Suvam1s/Human-Arm-Robot-Interfacing/README.md

# Human-Arm-Robot-Interfacing
Human arm–robot interface using MPU6050, flex sensors, and strain gauges to capture motion and finger activity. Processes signals to control a robotic hand in real time, with support for both wired and wireless communication for flexible operation.
