Suvam1s/Human-Arm-Robot-Interfacing/Introduction.md

# Human Motion Controlled Robotic Arm
### A Biomedical Instrumentation and Embedded Systems Project

## Overview

This repository presents the complete design, development, and implementation of a **Human Motion Controlled Robotic Arm** developed as an interdisciplinary engineering project integrating **Biomedical Engineering, Embedded Systems, Analog Electronics, Signal Processing, Mechanical Design, and Control Systems**.

The objective of this project extends beyond simply building a robotic arm. It serves as a comprehensive demonstration of designing a complete sensing and actuation system—from raw biological motion acquisition to stable real-time robotic control. Every stage of the system, including sensing, analog front-end design, signal conditioning, mathematical analysis, firmware development, mechanical integration, and simulation, has been developed and documented.

Unlike conventional robotic arm projects that directly interface sensors with microcontrollers, this project focuses heavily on the **engineering of reliable sensor interfaces** capable of extracting usable information from extremely small and noisy analog signals.

---

## Project Objective

Human joint motion generates sensor outputs that are often nonlinear, low amplitude, highly susceptible to electrical noise, and unsuitable for direct acquisition by a microcontroller.

The primary objective of this work is therefore to design a complete acquisition and control pipeline capable of:

- Acquiring weak analog signals from wearable sensing systems.
- Eliminating unwanted electrical noise while preserving useful motion information.
- Amplifying very low-frequency signals without introducing instability or amplifier saturation.
- Designing analog front-end circuits that remain stable over varying operating conditions.
- Producing clean, repeatable analog outputs suitable for ADC acquisition.
- Translating processed sensor signals into smooth robotic joint movements in real time.

The resulting system demonstrates a complete sensor-to-actuator pipeline rather than simply servo motor control.

---

## Engineering Scope

This repository combines multiple engineering disciplines into a single integrated project.

### Biomedical Instrumentation

- Human motion acquisition
- Wearable sensing techniques
- Joint angle estimation
- Biomechanical motion replication

### Analog Circuit Design

- Signal conditioning
- Precision amplification
- Active filtering
- Biasing circuits
- Wheatstone bridge implementation
- Sensor interface development
- Stable analog front-end design

### Signal Processing

Particular emphasis has been placed on extracting meaningful information from extremely low-frequency analog signals generated by wearable sensors.

The signal processing pipeline focuses on:

- Removal of unwanted electrical noise
- Isolation of useful low-frequency motion components
- Gain optimization
- Prevention of amplifier saturation
- Stable amplification of weak sensor outputs
- Analog signal conditioning suitable for ADC acquisition
- Reliable sensor calibration
- Real-time signal interpretation

The objective is not simply amplification, but the generation of clean, repeatable, and stable sensor outputs that can be used for accurate robotic control without jitter or instability.

### Embedded Systems

- ESP32 firmware development
- Real-time sensor acquisition
- PWM servo control
- ADC interfacing
- I²C communication
- Motion control algorithms

### Mechanical Design

The robotic arm has been mechanically designed to balance structural rigidity, low weight, and actuator efficiency through:

- Custom CAD modelling
- Servo mounting architecture
- Lightweight PVC structural members
- Spring-assisted elbow support
- Bearing-supported shoulder rotation
- Reinforced mechanical joints

---

## Sensor Technologies

The robotic arm employs multiple sensing technologies, each selected according to the biomechanics of the corresponding human joint.

- MPU6050 Inertial Measurement Unit for shoulder orientation.
- Flex Sensor for elbow motion detection.
- Four-element strain gauge system for wrist bend estimation.

Each sensing system is paired with a dedicated analog conditioning stage before being interfaced with the ESP32.

---

## Control Strategy

The robotic arm follows a **master-slave teleoperation architecture**, where human motion directly determines robotic joint movement.

Instead of autonomous trajectory planning, the system performs:

- Sensor acquisition
- Analog signal conditioning
- Motion estimation
- Joint angle mapping
- Real-time servo actuation

This approach allows natural replication of human arm movement while maintaining stable operation and predictable joint behaviour.

---

## Project Deliverables

This repository contains the complete engineering workflow behind the project, including:

- Mechanical CAD models
- Circuit design
- Signal conditioning circuitry
- Mathematical derivations
- MATLAB analysis and simulations
- Embedded firmware
- Experimental validation
- Design documentation
- Engineering calculations
- Assembly resources

---

## Purpose of this Repository

This repository is intended to serve as both a project archive and an engineering portfolio demonstrating practical experience in:

- Biomedical instrumentation
- Embedded systems
- Analog electronics
- Signal conditioning
- Sensor interface design
- Real-time control systems
- Mechanical system integration
- MATLAB modelling and simulation
- Firmware development
- Engineering documentation

Rather than focusing on a single subsystem, this project demonstrates the complete engineering workflow required to transform weak physiological motion signals into reliable robotic actuation through carefully designed sensing, analog processing, digital control, and mechanical implementation.
