Suvam1s/Human-Arm-Robot-Interfacing/Control Systems/Flex Sensor Control/Circuits/Lowpass filter.png

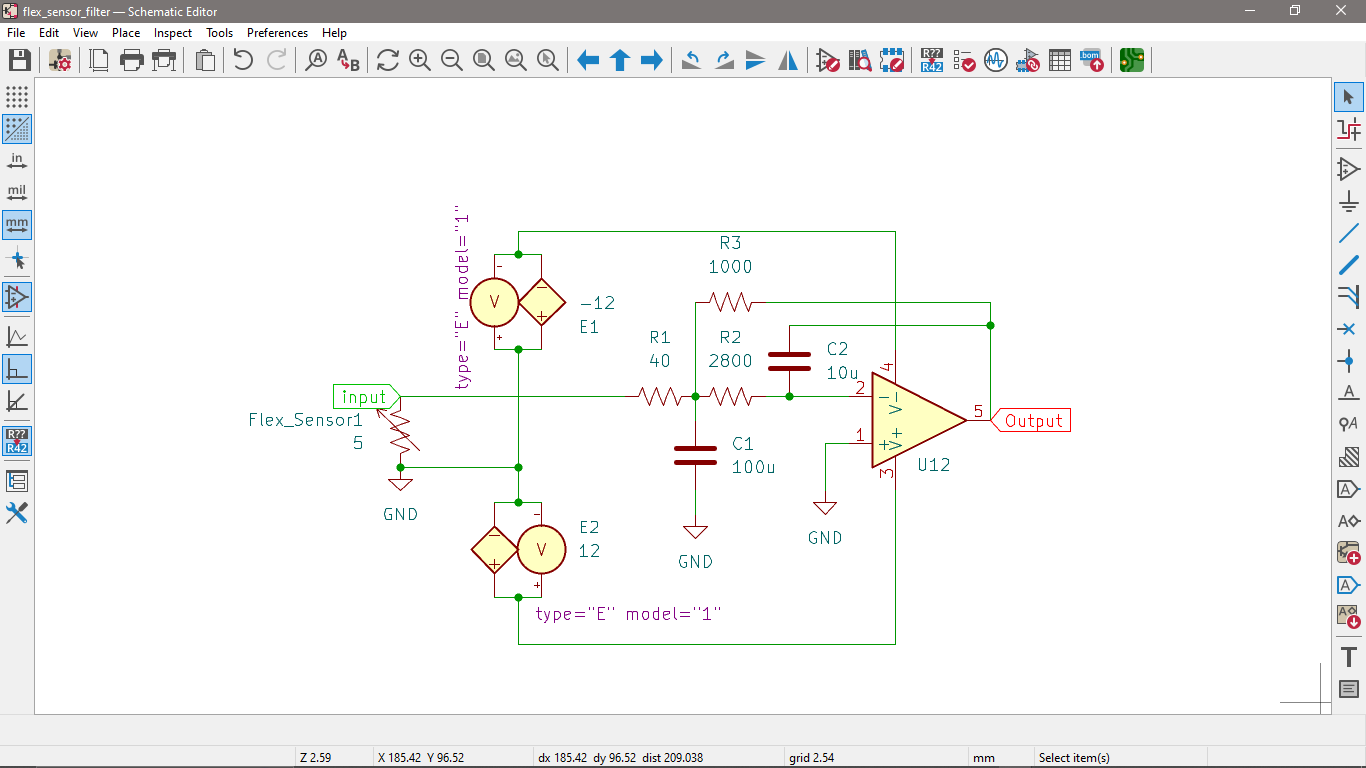
Control Systems/Flex Sensor Control/Circuits/Lowpass filter.png
