Suvam1s/Human-Arm-Robot-Interfacing/Control Systems/Flex Sensor Control/Matlab simulation/Control Data extraction/output simulation.png

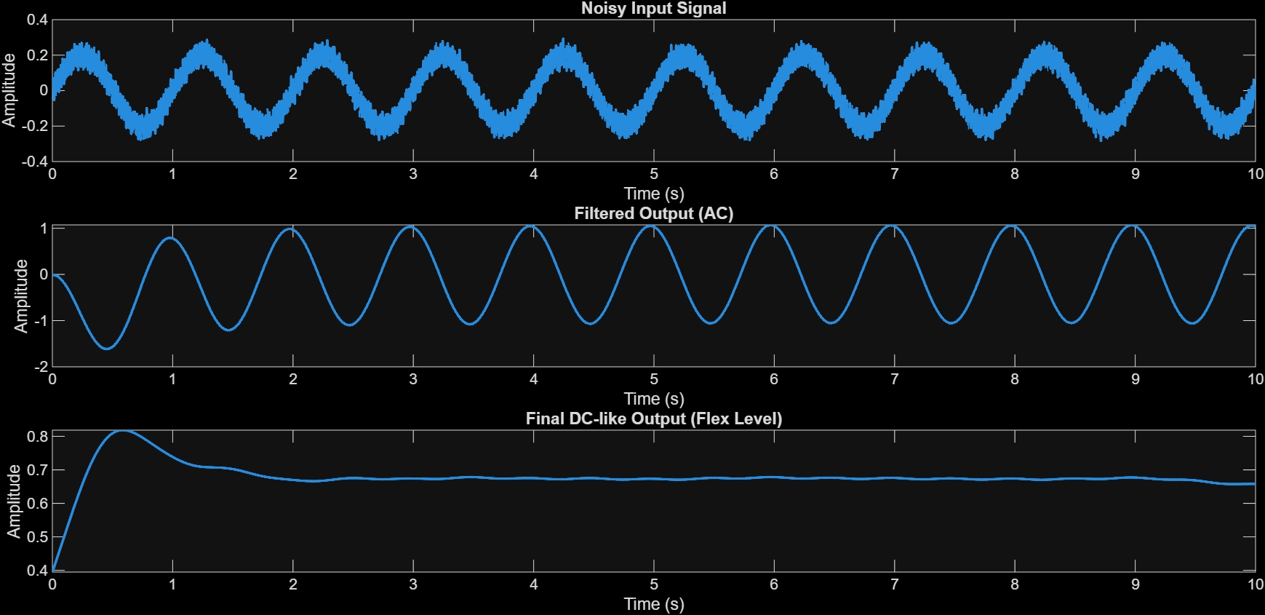
Control Systems/Flex Sensor Control/Matlab simulation/Control Data extraction/output simulation.png
