Suvam1s/Human-Arm-Robot-Interfacing/Control Systems/Flex Sensor Control/Matlab simulation/Lowpass Filter trans data/3D s plane.png

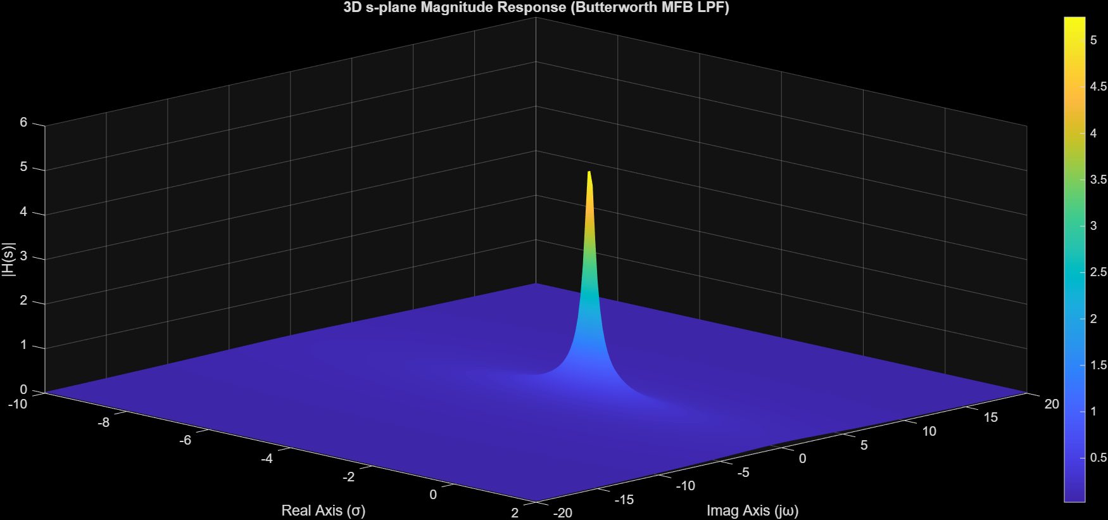
Control Systems/Flex Sensor Control/Matlab simulation/Lowpass Filter trans data/3D s plane.png
