Suvam1s/Human-Arm-Robot-Interfacing/Control Systems/Flex Sensor Control/Matlab simulation/Lowpass Filter trans data/Impulse Response.png

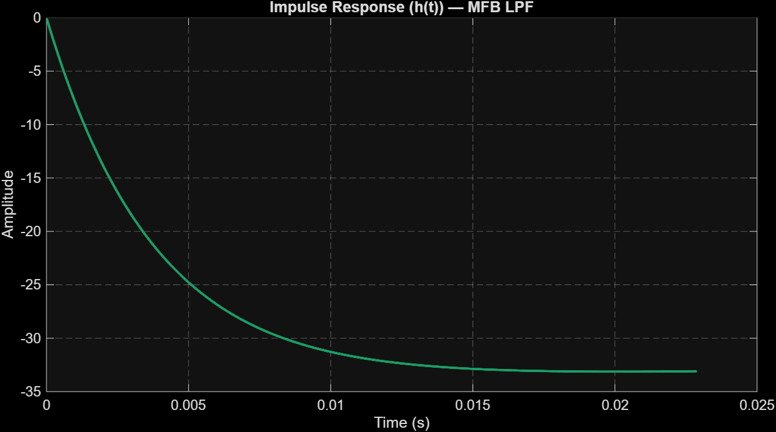
Control Systems/Flex Sensor Control/Matlab simulation/Lowpass Filter trans data/Impulse Response.png
