Suvam1s/Human-Arm-Robot-Interfacing/Control Systems/Full System Circuit.png

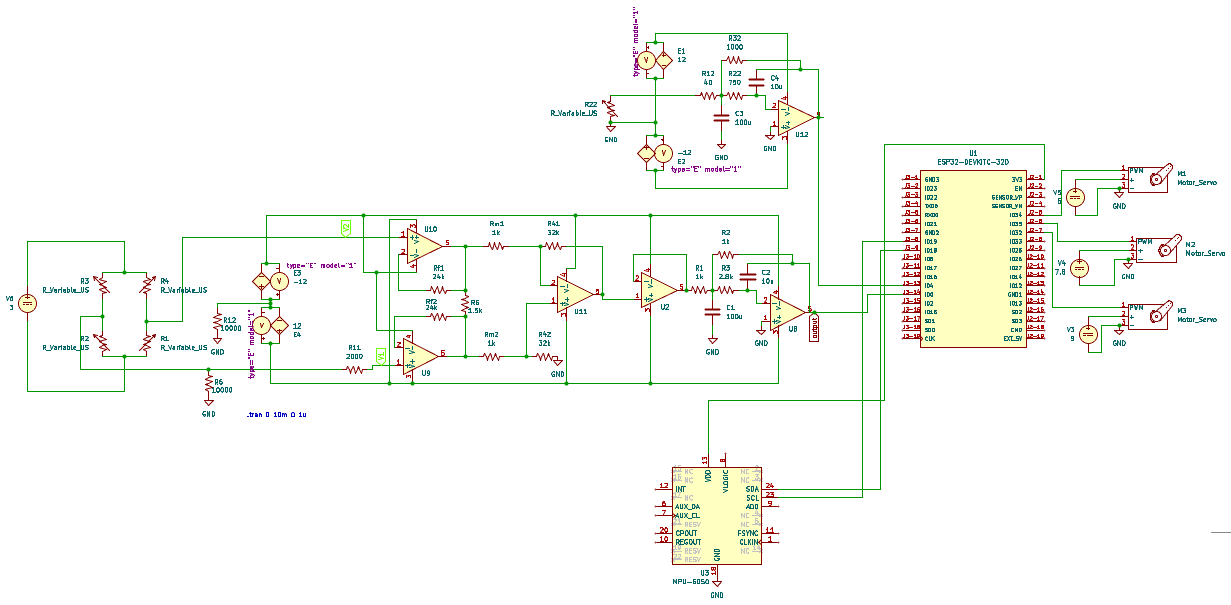
Control Systems/Full System Circuit.png
