Suvam1s/Human-Arm-Robot-Interfacing/Control Systems/Strain Gauge Control/Circuit/Amplifier.png

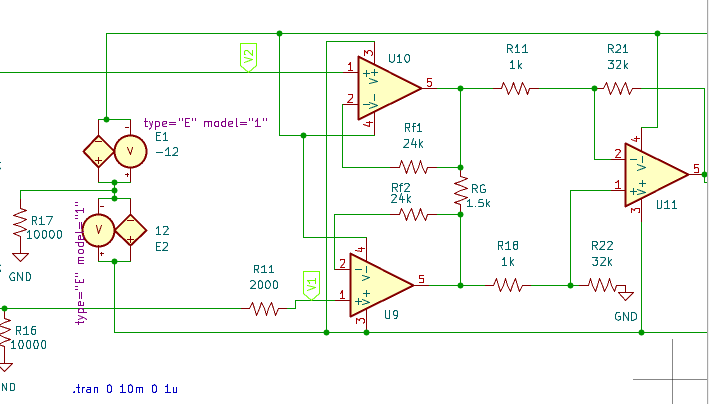
Control Systems/Strain Gauge Control/Circuit/Amplifier.png
