Suvam1s/Human-Arm-Robot-Interfacing/Control Systems/Strain Gauge Control/Circuit/Buffer with Lowpass filter.png

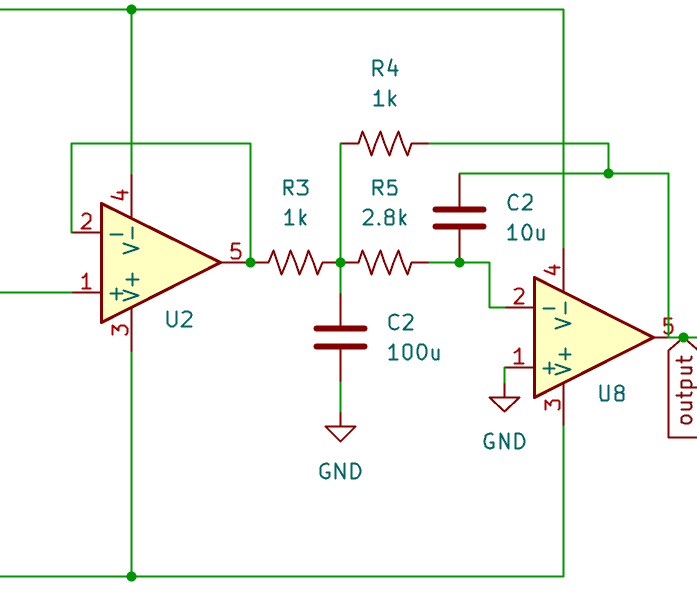
Control Systems/Strain Gauge Control/Circuit/Buffer with Lowpass filter.png
