Suvam1s/Human-Arm-Robot-Interfacing/Control Systems/Strain Gauge Control/Circuit/Full Circuit.png

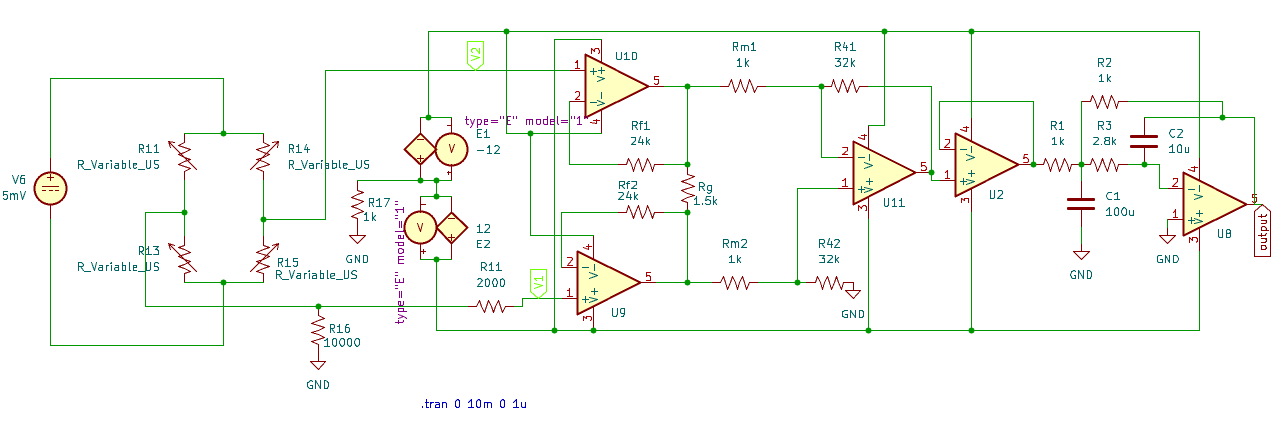
Control Systems/Strain Gauge Control/Circuit/Full Circuit.png
