Suvam1s/Human-Arm-Robot-Interfacing/Control Systems/Strain Gauge Control/Matlab simulation/Amplifier/Bode Plot.png

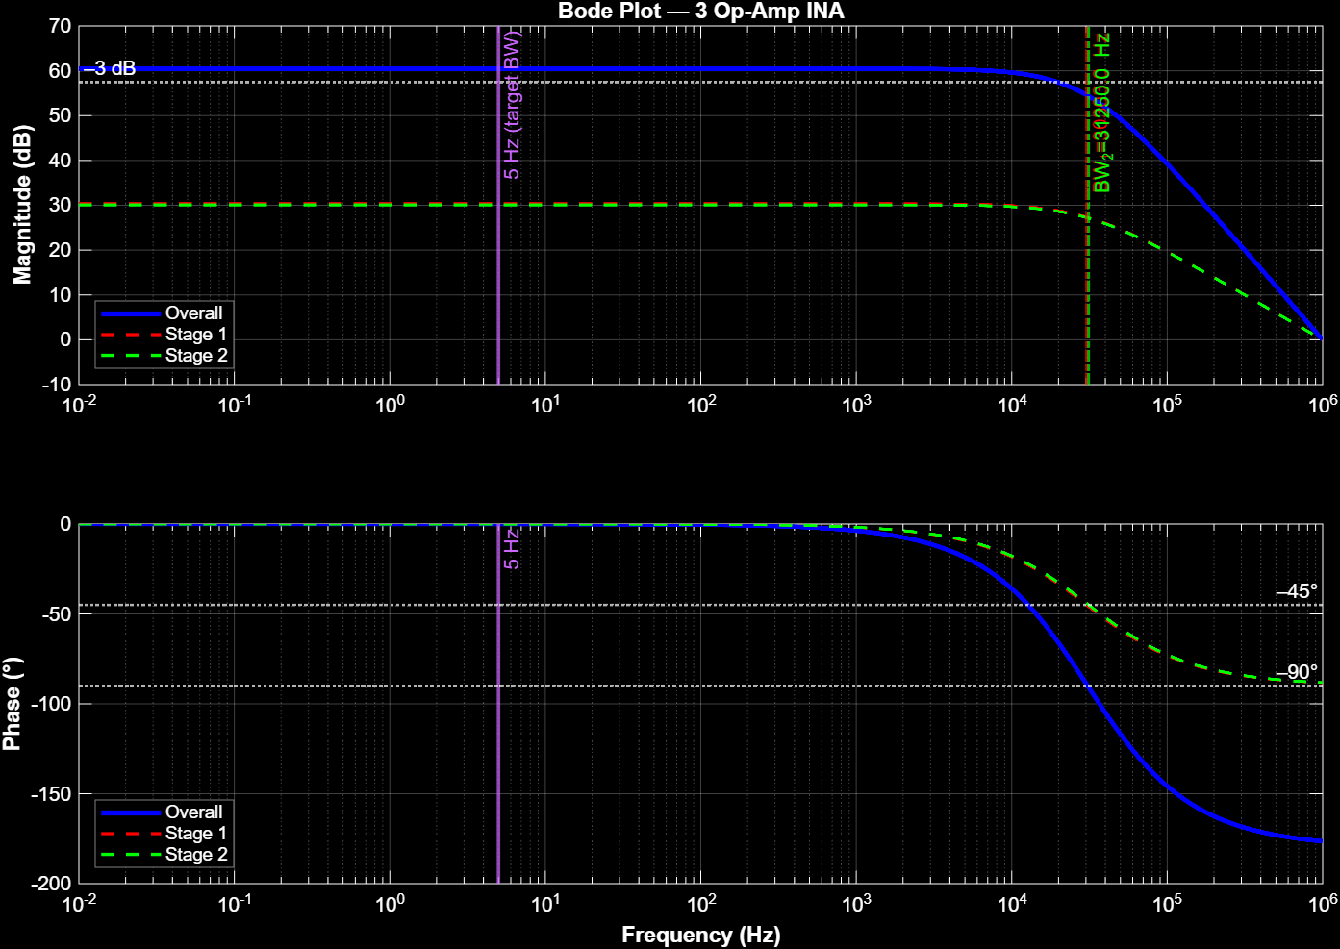
Control Systems/Strain Gauge Control/Matlab simulation/Amplifier/Bode Plot.png
