Suvam1s/Human-Arm-Robot-Interfacing/Control Systems/Strain Gauge Control/Matlab simulation/Amplifier/CMRR Analysis.png

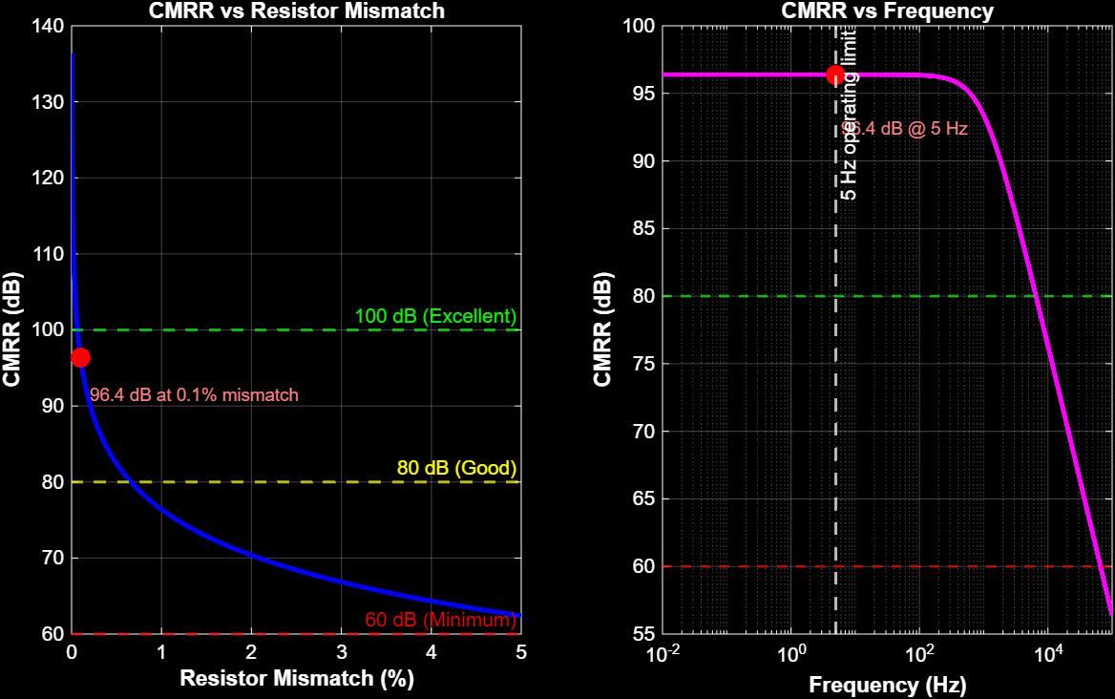
Control Systems/Strain Gauge Control/Matlab simulation/Amplifier/CMRR Analysis.png
