Suvam1s/Human-Arm-Robot-Interfacing/Control Systems/Strain Gauge Control/Matlab simulation/Amplifier/FullCircuit_Simulated_Output.png

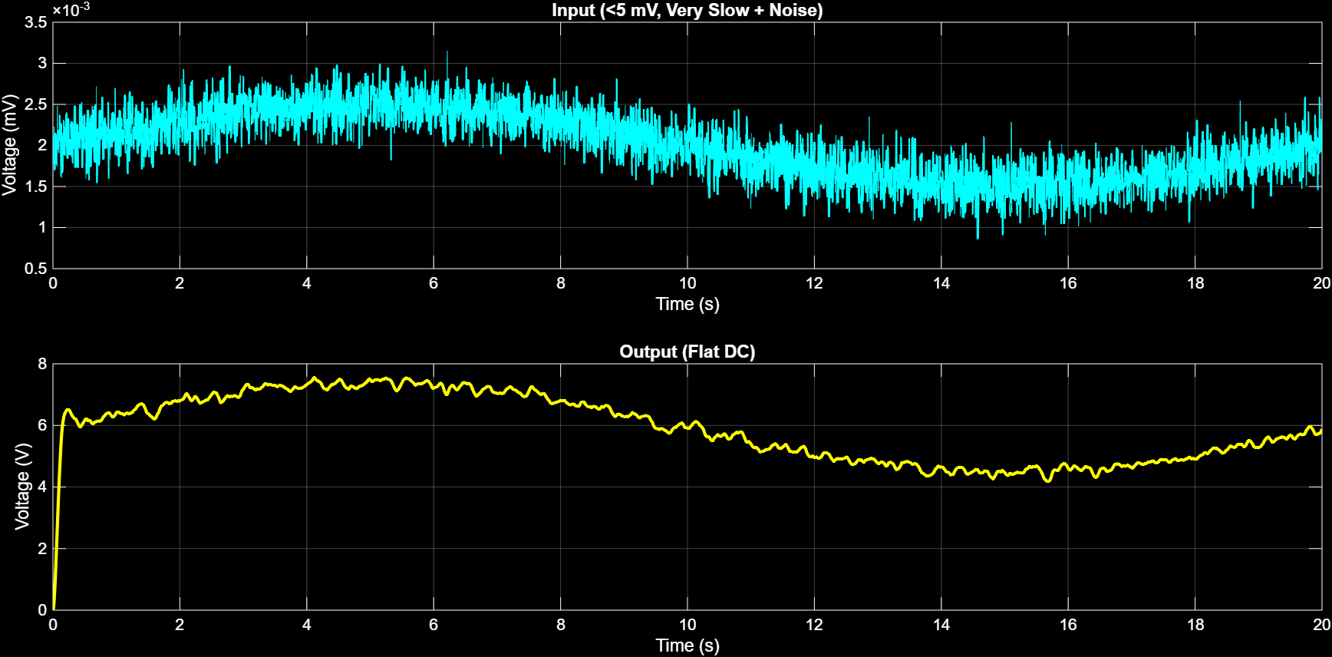
Control Systems/Strain Gauge Control/Matlab simulation/Amplifier/FullCircuit_Simulated_Output.png
