Suvam1s/Human-Arm-Robot-Interfacing/Control Systems/Strain Gauge Control/Matlab simulation/Amplifier/Gain Sensitivity.png

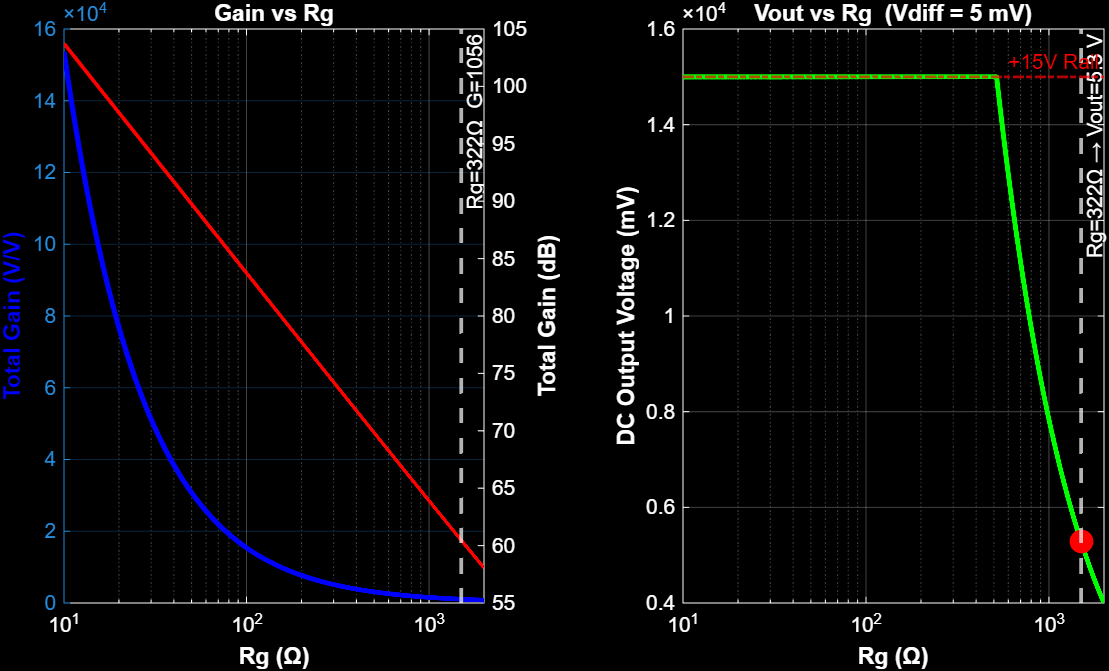
Control Systems/Strain Gauge Control/Matlab simulation/Amplifier/Gain Sensitivity.png
