Suvam1s/Human-Arm-Robot-Interfacing/Control Systems/Strain Gauge Control/Matlab simulation/Amplifier/Time Domain.png

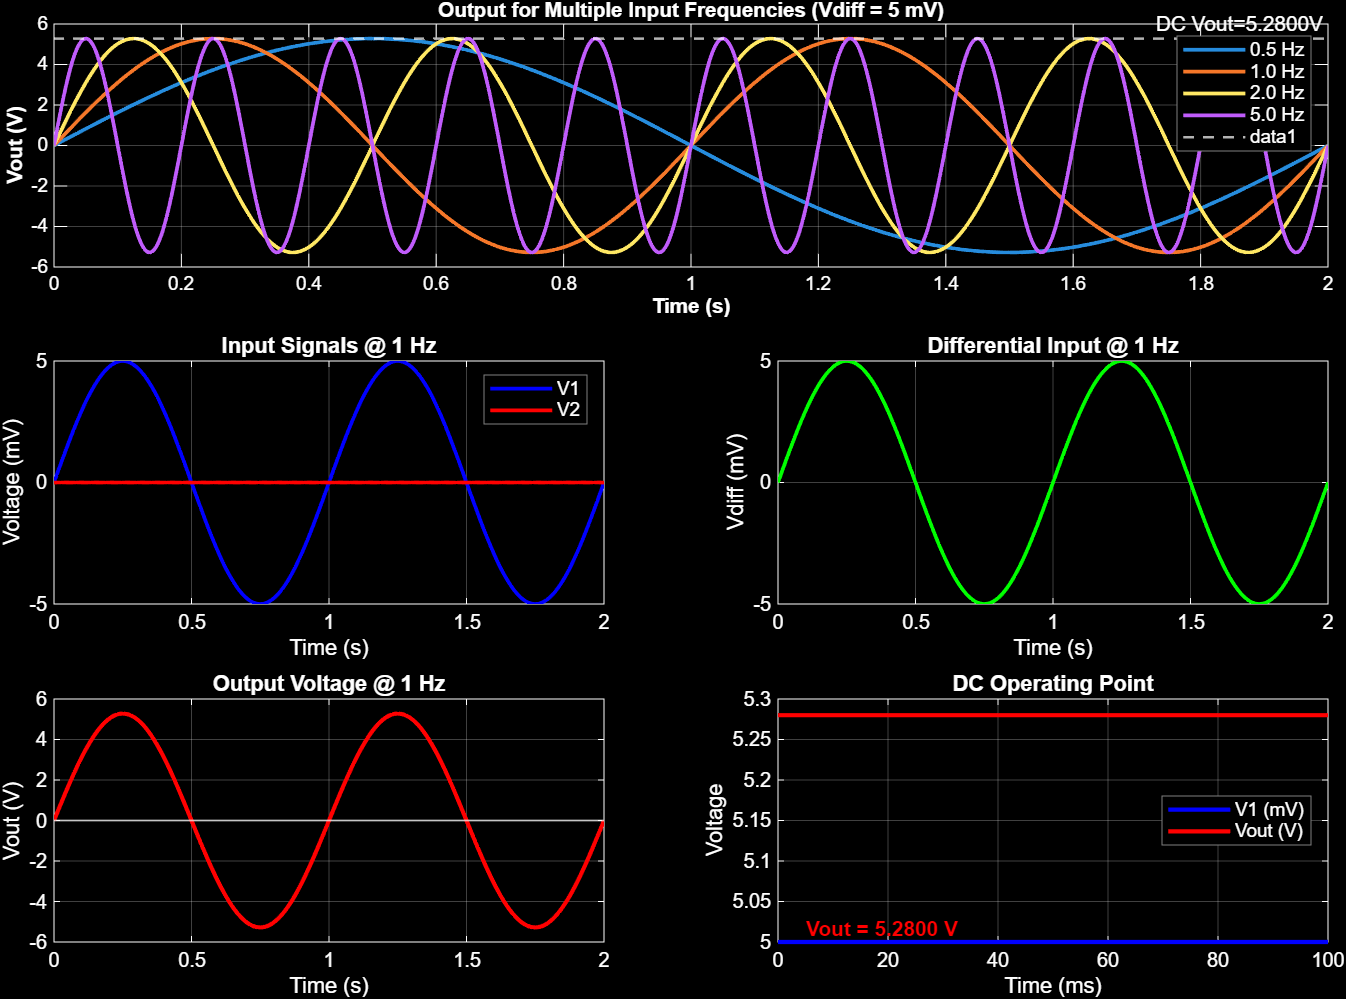
Control Systems/Strain Gauge Control/Matlab simulation/Amplifier/Time Domain.png
