Suvam1s/Human-Arm-Robot-Interfacing/Control Systems/Strain Gauge Control/Matlab simulation/Full circuit/Group Delay.png

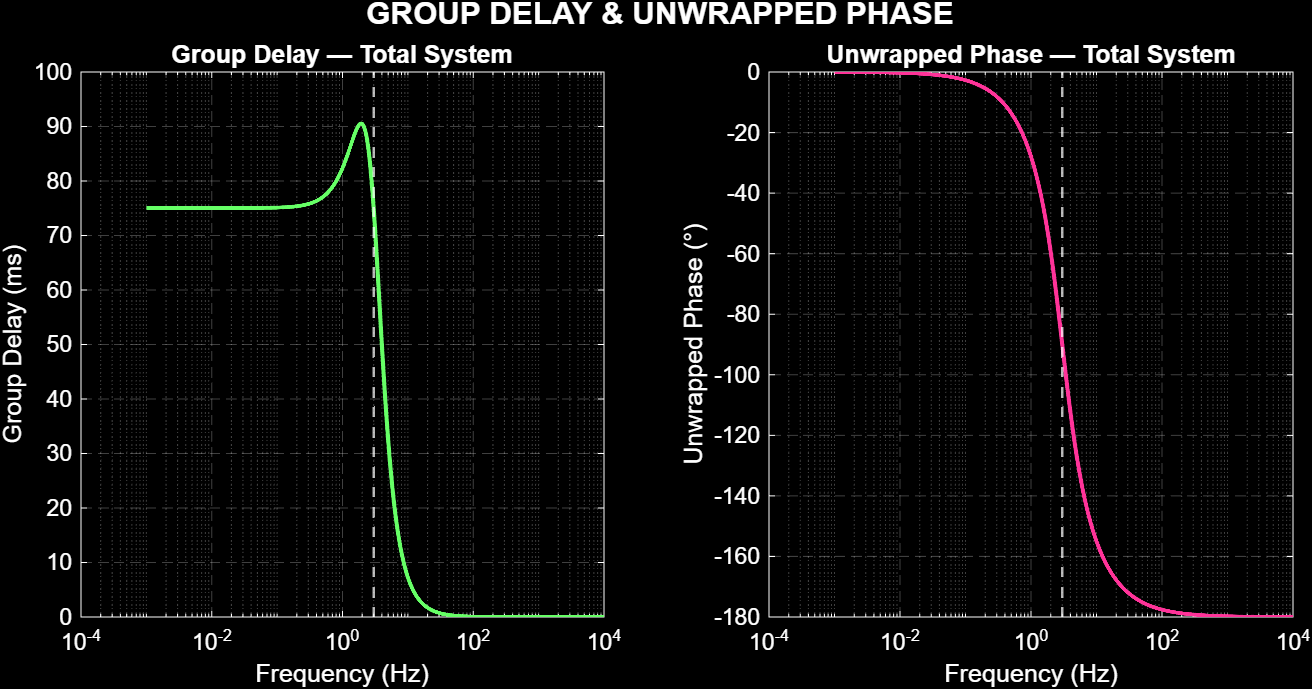
Control Systems/Strain Gauge Control/Matlab simulation/Full circuit/Group Delay.png
