Suvam1s/Human-Arm-Robot-Interfacing/Control Systems/Strain Gauge Control/Matlab simulation/Full circuit/Pole-Zero Map.png

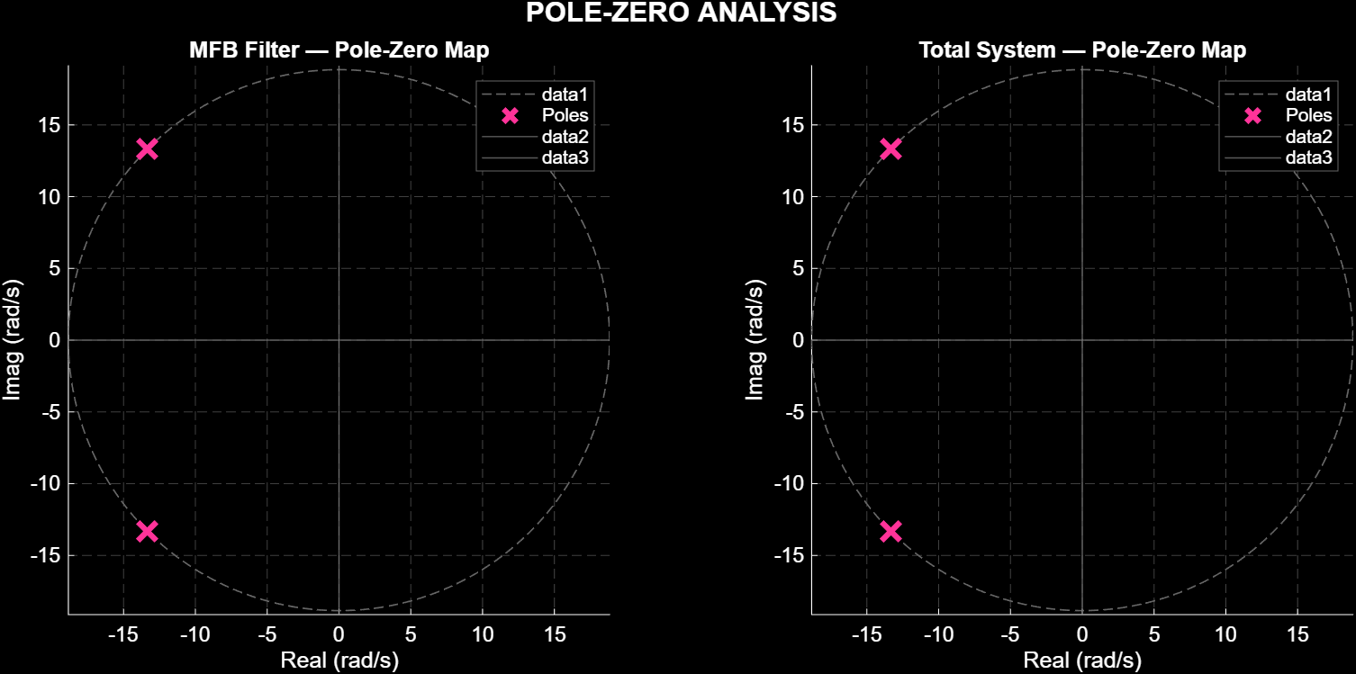
Control Systems/Strain Gauge Control/Matlab simulation/Full circuit/Pole-Zero Map.png
