Suvam1s/Human-Arm-Robot-Interfacing/Control Systems/Strain Gauge Control/Matlab simulation/Full circuit/Summary Dashboard.png

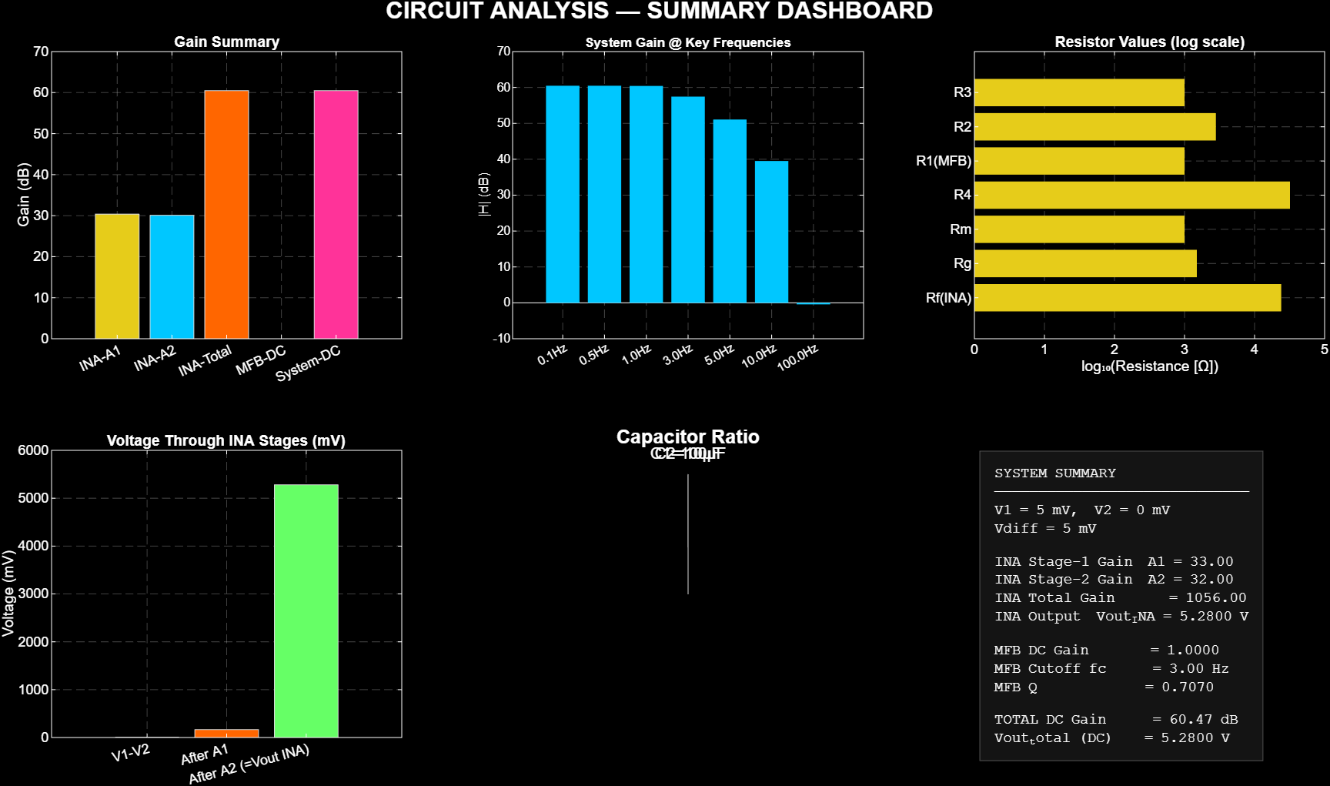
Control Systems/Strain Gauge Control/Matlab simulation/Full circuit/Summary Dashboard.png
