Suvam1s/Human-Arm-Robot-Interfacing/Control Systems/Strain Gauge Control/Matlab simulation/Full circuit/Time Domain Signal.png

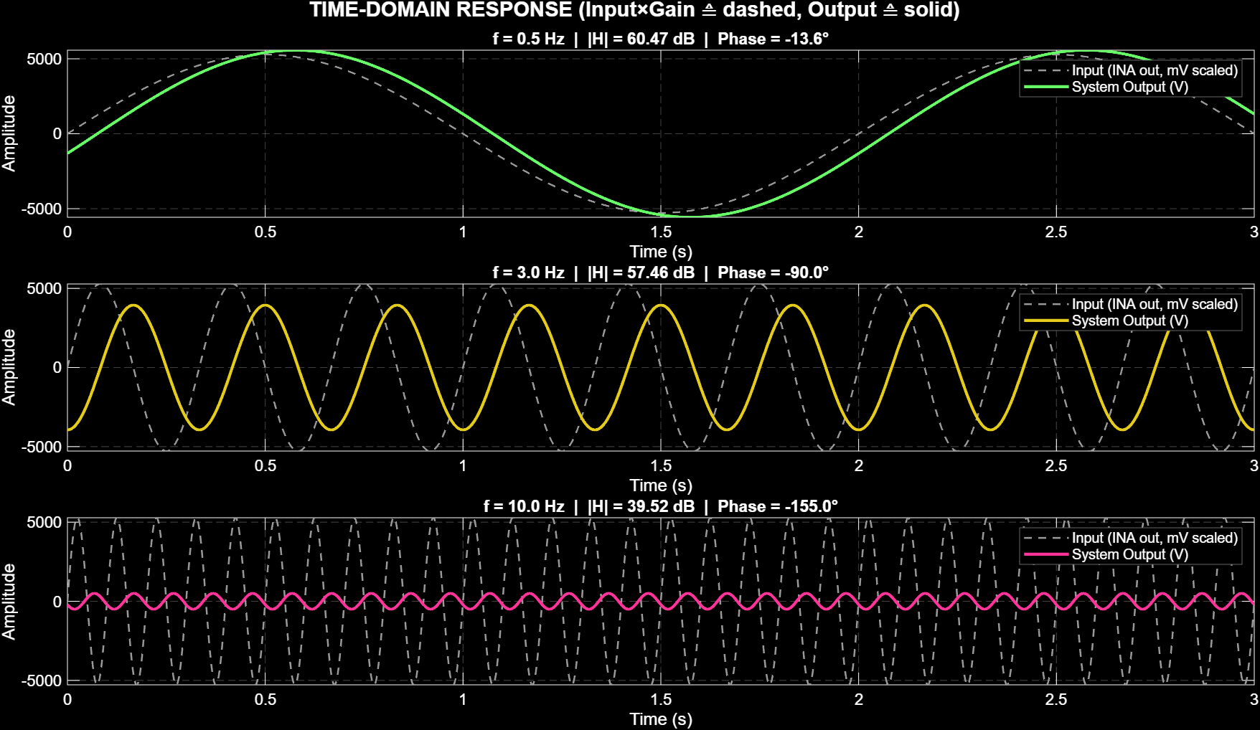
Control Systems/Strain Gauge Control/Matlab simulation/Full circuit/Time Domain Signal.png
