Suvam1s/Human-Arm-Robot-Interfacing/Control Systems/Strain Gauge Control/Matlab simulation/Low pass filter/ouput/Data Extraction Simulation.png

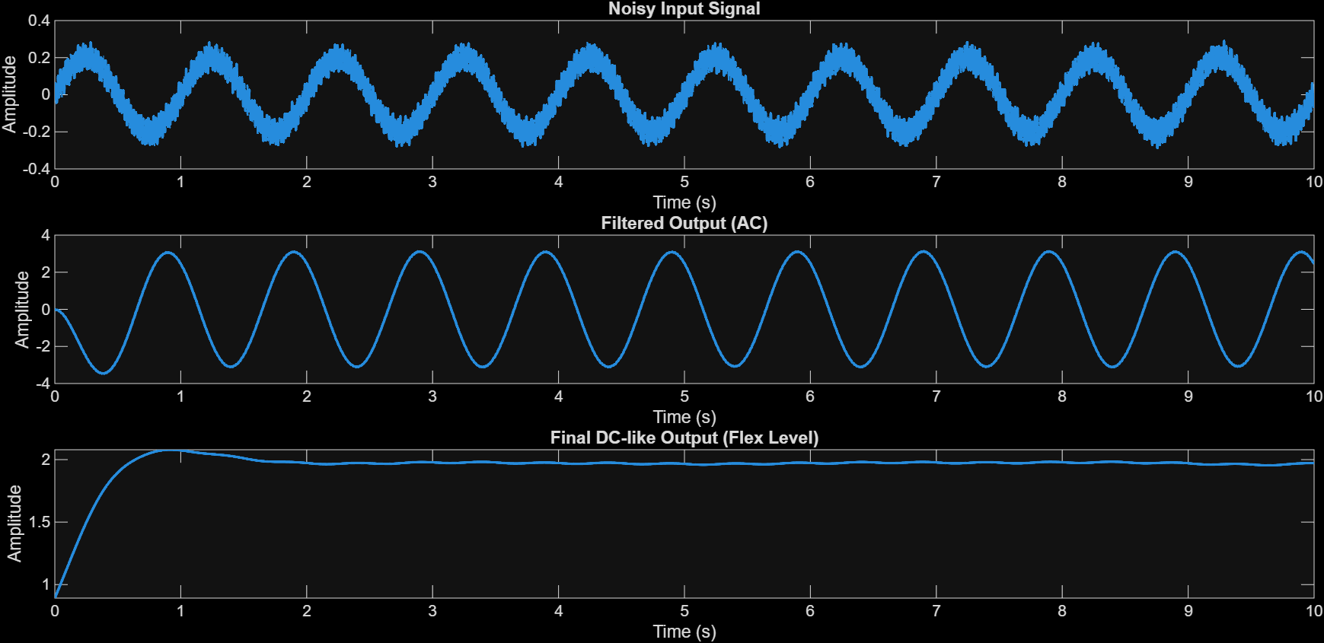
Control Systems/Strain Gauge Control/Matlab simulation/Low pass filter/ouput/Data Extraction Simulation.png
