Suvam1s/Human-Arm-Robot-Interfacing/Physical Consturction & Data/Autocad drawings/Front Left Corner view.png

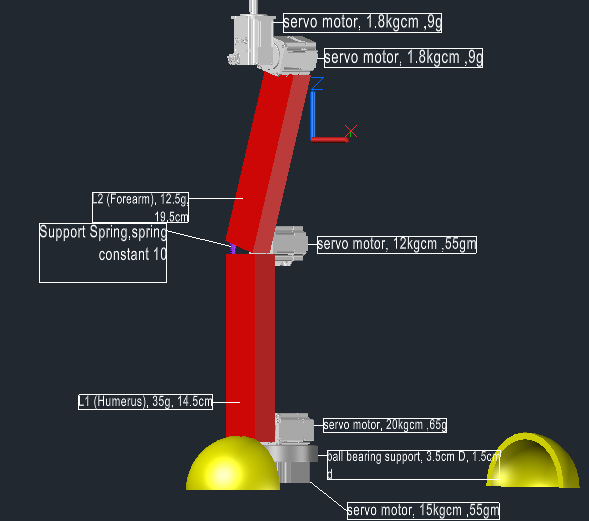
Physical Consturction & Data/Autocad drawings/Front Left Corner view.png
