Suvam1s/Human-Arm-Robot-Interfacing/Physical Consturction & Data/Autocad drawings/Front View.png

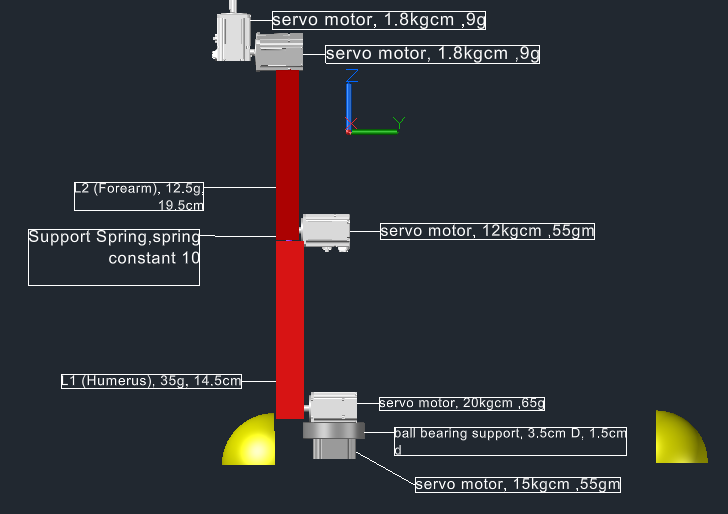
Physical Consturction & Data/Autocad drawings/Front View.png
