Suvam1s/Human-Arm-Robot-Interfacing/(list of files, cad)

Other CAD files:
Physical Consturction & Data/Autocad drawings/robohand.dwg
