Suvam1s/Human-Arm-Robot-Interfacing/Control Systems/Strain Gauge Control/Matlab simulation/Amplifier/Operating Band Gain.png

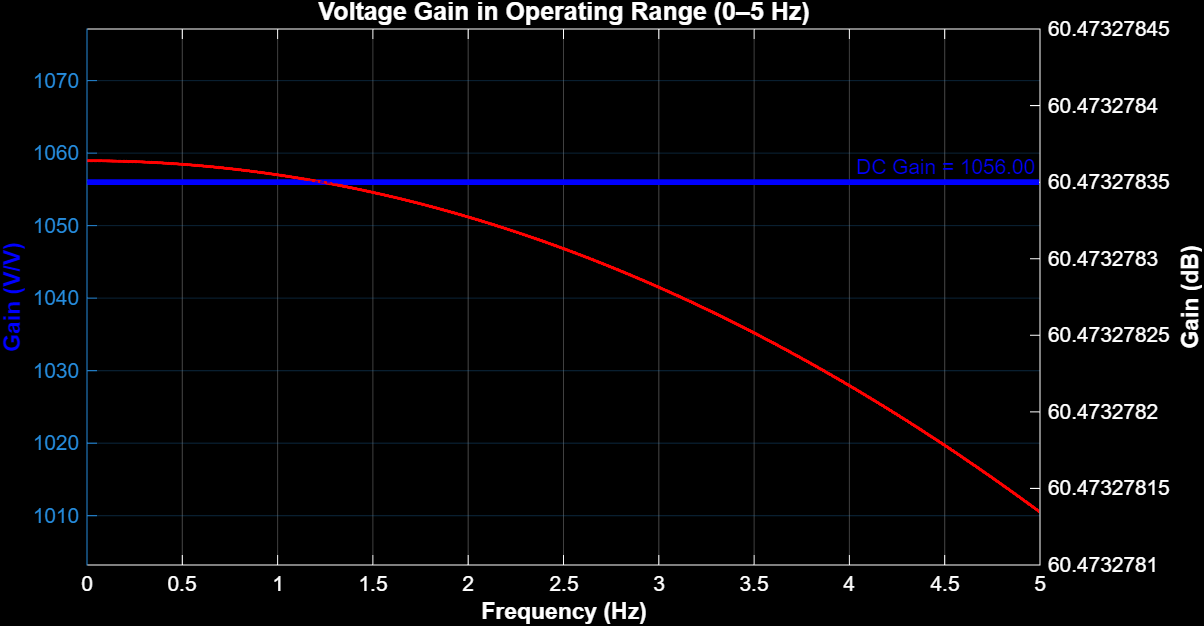
Control Systems/Strain Gauge Control/Matlab simulation/Amplifier/Operating Band Gain.png
