Suvam1s/Human-Arm-Robot-Interfacing/Control Systems/Strain Gauge Control/Matlab simulation/Amplifier/Pole-Zero & Step Response.png

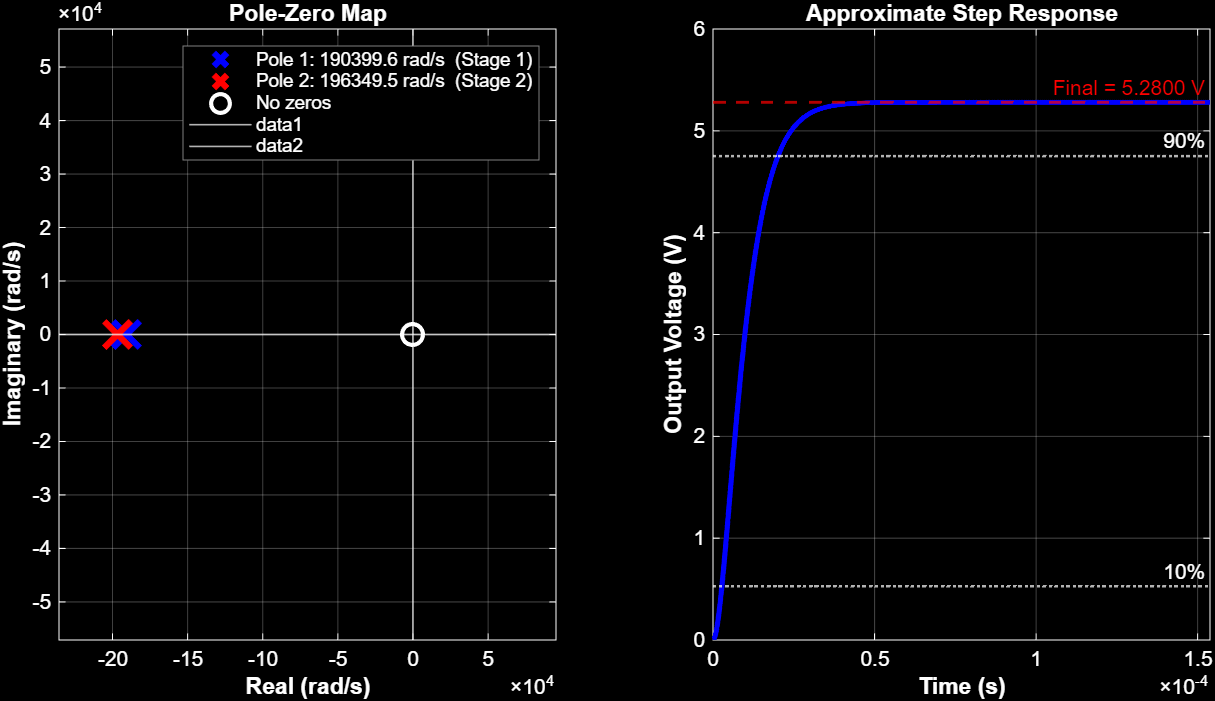
Control Systems/Strain Gauge Control/Matlab simulation/Amplifier/Pole-Zero & Step Response.png
