Suvam1s/Human-Arm-Robot-Interfacing/Control Systems/Strain Gauge Control/Matlab simulation/Full circuit/Step Response.png

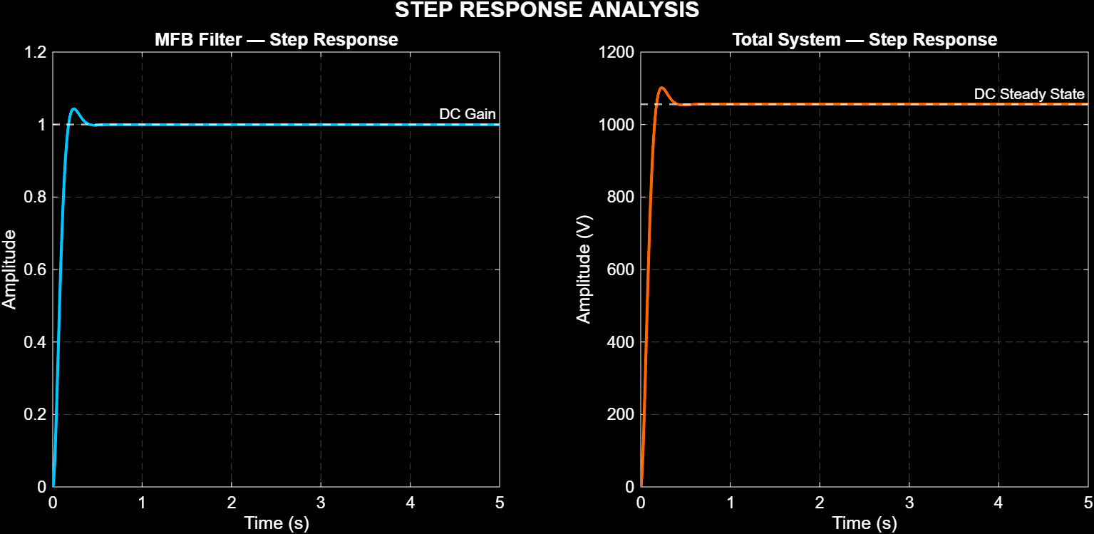
Control Systems/Strain Gauge Control/Matlab simulation/Full circuit/Step Response.png
