Suvam1s/Human-Arm-Robot-Interfacing/Control Systems/Strain Gauge Control/Matlab simulation/Amplifier/Transfer Characteristic.png

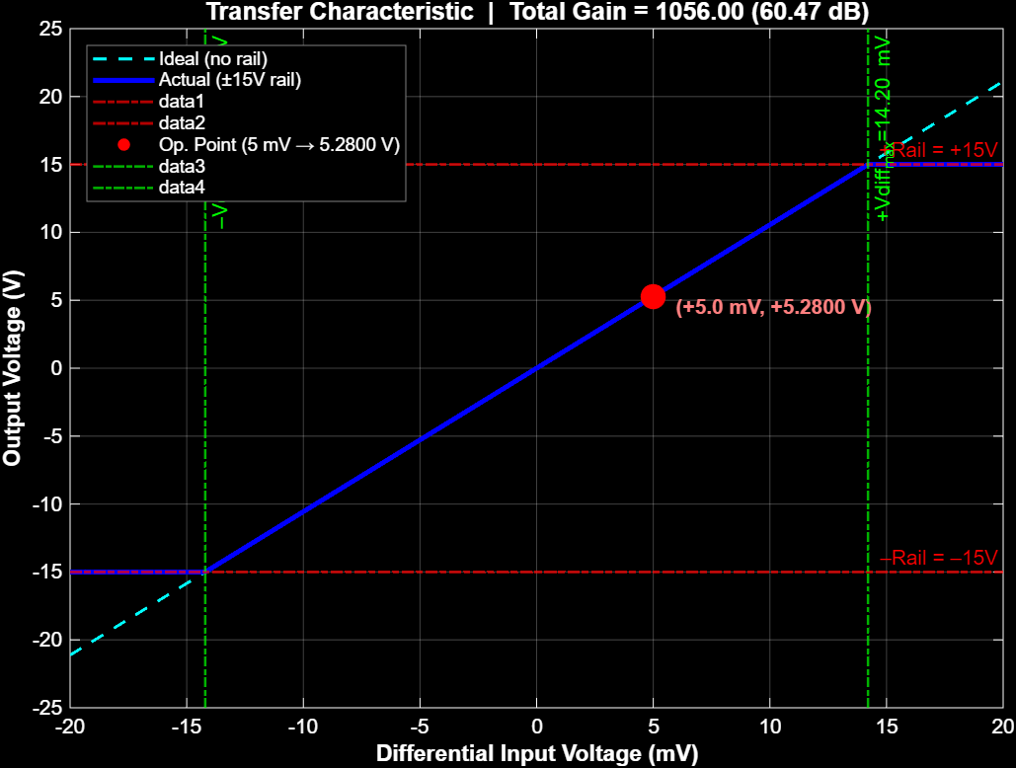
Control Systems/Strain Gauge Control/Matlab simulation/Amplifier/Transfer Characteristic.png
