Suvam1s/Human-Arm-Robot-Interfacing/Control Systems/Flex Sensor Control/Circuits/flex_sensor_filter.kicad_sch

## KiCad design Control Systems/Flex Sensor Control/Circuits/flex_sensor_filter.kicad_sch (2026-04-15)

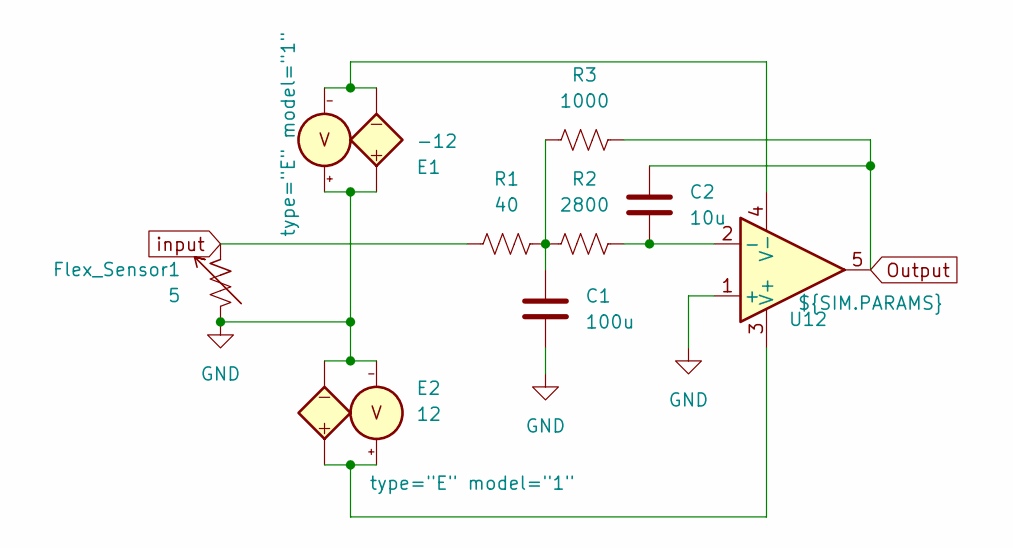
[picture p35: schematic flex_sensor_filter.kicad_sch]

Parts:
C1: 100u
C2: 10u
E1: -12
E2: 12
Flex_Sensor1: 5
R1: 40
R2: 2800
R3: 1000
U12: ${SIM.PARAMS}

Connections:
GND: C1.2, E1.1 (N+), E1.3 (C+), E2.2 (N-), E2.4 (C-), Flex_Sensor1.2, U12.1 (+)
unnamed: C1.1, R1.2, R2.1, R3.1
unnamed: C2.2, R2.2, U12.2 (-)
unnamed: E1.2 (N-), E1.4 (C-), U12.4 (V-)
unnamed: E2.1 (N+), E2.3 (C+), U12.3 (V+)
Output: C2.1, R3.2, U12.5
input: Flex_Sensor1.1, R1.1
