Suvam1s/Human-Arm-Robot-Interfacing/(commit log)

2026-03-29 Create Flex sensor control
2026-04-15 Update ButterWorth_active_Lowpass filter_(MFB_topology)_Matlab_analysis_Code.m
2026-07-21 Update and rename Readme.md to Materialsused.md
2026-08-23 Create Movements & joints of the robot
